iesverhage/crownstone-smart-outlet-tag/documents/Foto's/PCB-3D.jpg

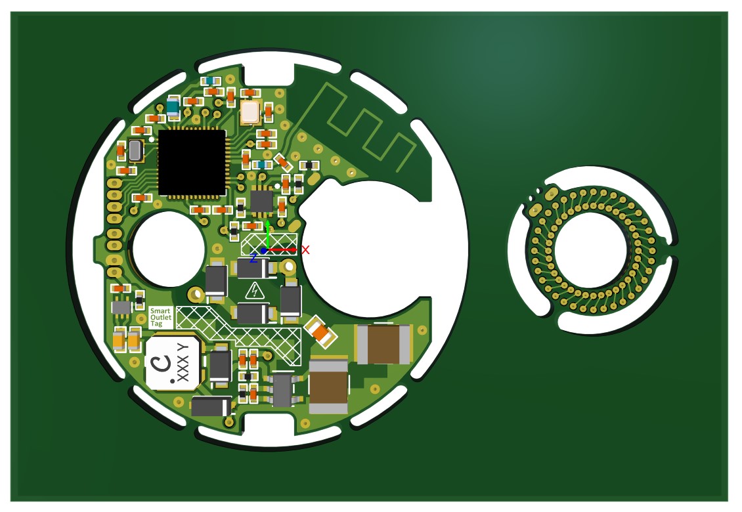
documents/Foto's/PCB-3D.jpg
