iesverhage/crownstone-smart-outlet-tag/documents/Foto's/PCB-2D.jpg

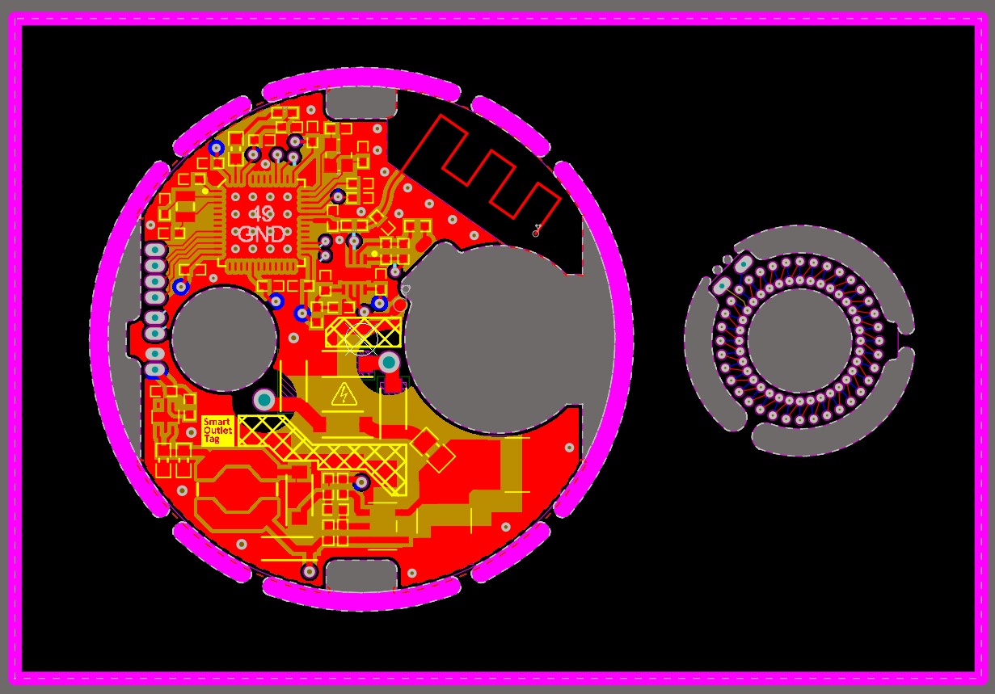
documents/Foto's/PCB-2D.jpg
