iesverhage/crownstone-smart-outlet-tag/documents/Foto's/Circuit.pdf

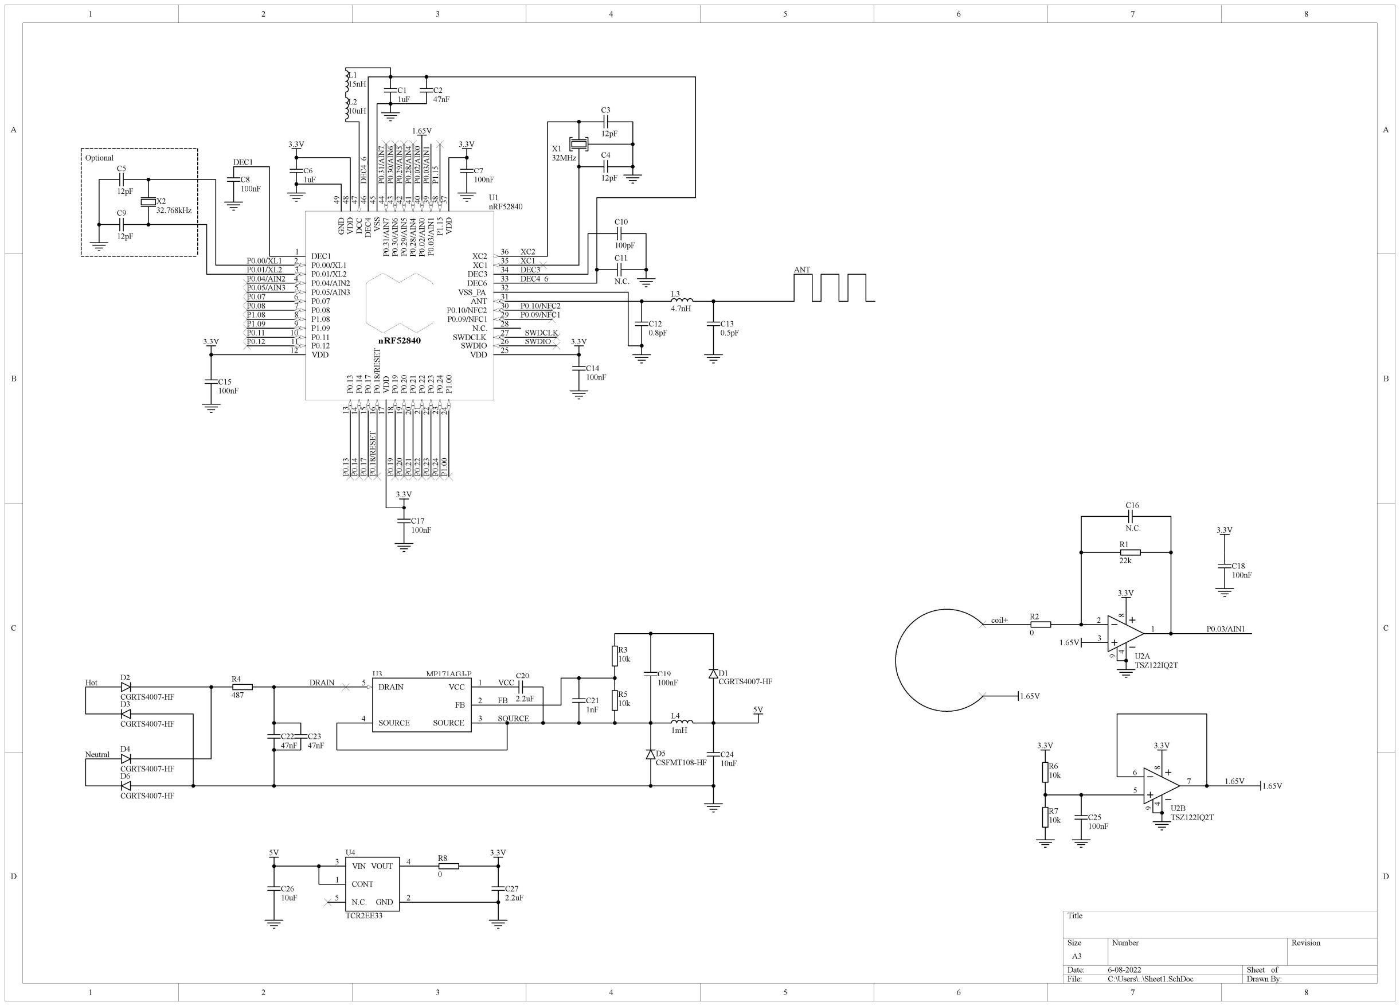
[picture p3: page 1]

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
Title

Size | Number | Revision
A3
Date: | 6-08-2022 | Sheet of
File: | C:\Users\..\Sheet1.SchDoc | Drawn By:

P0.07

P0.11
P0.12

P1.09

P0.00/XL1
P0.01/XL2
P0.04/AIN2
P0.05/AIN3

XC1

XC2

P0.10/NFC2 P⁰.18/RESET | P⁰.19 P⁰.20 P⁰.21 P⁰.22 P⁰.23 | P¹.00

SWDCLK

SWDIO P⁰.02/AIN⁰ P⁰.03/AIN¹

DEC3

P0.09/NFC1

Optional | P¹.15

P0.08

P1.08 | P⁰.13 P⁰.14 P⁰.17 | P⁰.24 P⁰.31/AIN⁷ P⁰.30/AIN⁶ P⁰.29/AIN⁵ P⁰.28/AIN⁴
DEC4_6 DEC⁴_6DEC1

C15
100nF

C17
100nF

C14
100nF

C8
100nF

C7
100nF

C6
1uF

C1
1uF

C9

12pF

C5

12pF

C4

12pF

C3

12pF

C10

100pF

C2
47nF

C11

N.C.

C12
0.8pF

L3
4.7nH

C13
0.5pF

L1
15nH

L2
10uH

X1
32MHz

X2
32.768kHz

DEC1 1

P1.09 9

VSS_PA | 32
ANT | 31
DEC6 | 33 DEC3 | 34 XC1 | 35 XC2 | 36
P0.00/XL1 2
P0.01/XL2 3
P0.04/AIN2 4
P0.05/AIN3 5
P0.07 6
P0.08 7
P1.08 8

P0.11 10
P0.12 11
VDD 12 | P⁰.13 13
SWDIO | 26 SWDCLK | 27 N.C. | 28 P0.09/NFC1 | 29
nRF52840 P⁰.14 14 P⁰.17 15 P⁰.18/RESET 16 VDD 17 P⁰.19 18 P⁰.20 19 P⁰.21 20 P⁰.22 21 P⁰.23 22 P⁰.24 23 P¹.00 24 P⁰.30/AIN⁶ ⁴³ P⁰.31/AIN⁷ ⁴⁴ DEC⁴ ⁴⁶ VSS ⁴⁵ VDD ⁴⁸ DCC ⁴⁷ | P¹.15 38 P⁰.03/AIN¹ ³⁹ P⁰.02/AIN⁰ ⁴⁰ P⁰.28/AIN⁴ ⁴¹ P⁰.29/AIN⁵ ⁴²
VDD | 25
P0.10/NFC2 | 30 GND ⁴⁹ | VDD ³⁷ | U1
nRF52840

ANT

3.3V

coil+

1.65V

1.65V

3.3V

VCC | 1
FB | 2
SOURCE | 3 SOURCE 4

DRAIN 5

U3 | MP171AGJ-P

1

2

3 4

9

8

U2A
TSZ122IQ2T

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
N.C.

C18
100nF

C25
100nF

C19
100nF

D1
CGRTS4007-HF D2

CGRTS4007-HF

D6

CGRTS4007-HF

D5
CSFMT108-HF

C24
10uF

C20

2.2uF

C26
10uF

C27
2.2uF
5V | 3.3V

7

6

5 4

9

8

U2B
TSZ122IQ2T

3.3V

3.3V

C23
47nF

C22
47nF

D3

CGRTS4007-HF

D4

CGRTS4007-HF

L4
1mH

1.65V

R1

22k

Hot

Neutral

FB

VCC

SOURCE

DRAIN

C21
1nF

1.65V

3.3V

3.3V | 3.3V
3.3V | 3.3V

P0.03/AIN1

1.65V

R8

0

R2

0

R4

487

CONT 1

VIN 3

N.C. 5

VOUT | 4
GND | 2

U4

TCR2EE33
