iesverhage/crownstone-smart-outlet-tag/documents/Planning/Planning_v0.9.pdf

Powered by TCPDF (www.tcpdf.org)

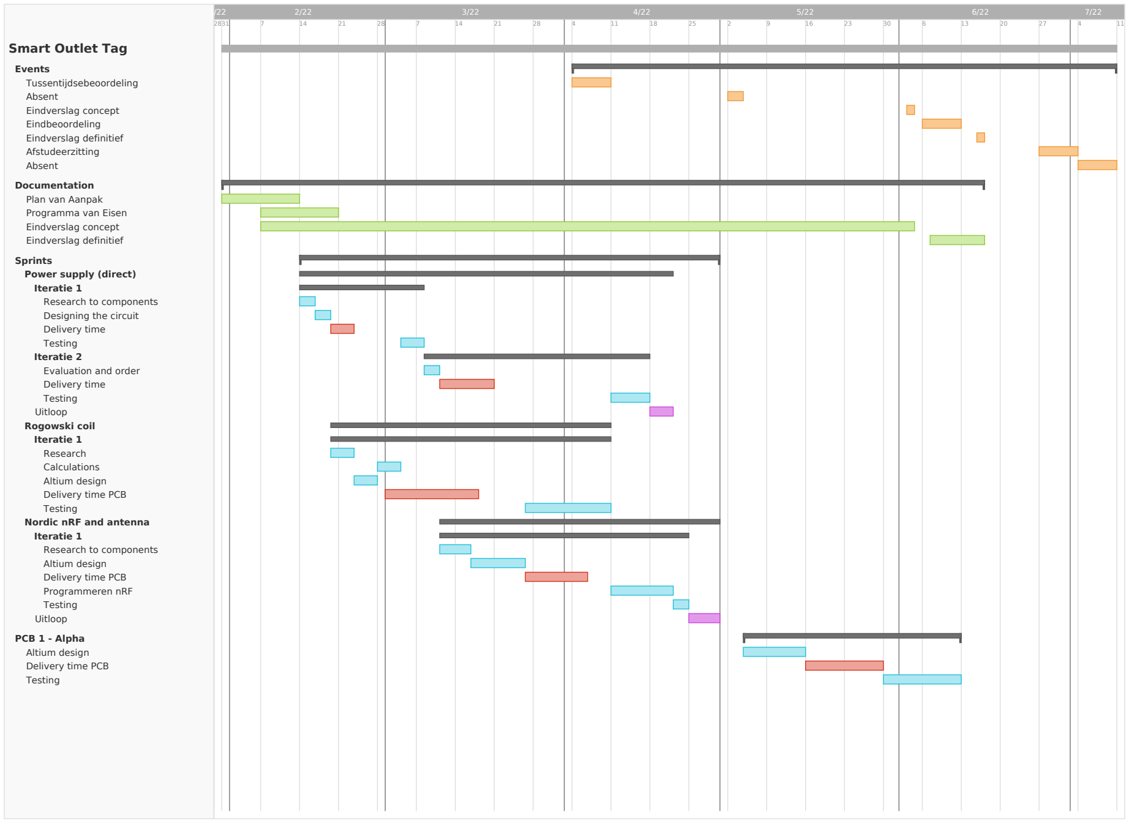
[picture p4: figure]
Smart Outlet Tag; Events Tussentijdsebeoordeling Absent Eindverslag concept Eindbeoordeling Eindverslag definitief Afstudeerzitting Absent; Documentation Plan van Aanpak Programma van Eisen Eindverslag concept Eindverslag definitief; Sprints Power supply (direct) Iteratie 1 Research to components Designing the circuit Delivery time Testing Iteratie 2 Evaluation and order Delivery time Testing Uitloop Rogowski coil Iteratie 1 Research Calculations Altium design Delivery time PCB Testing Nordic nRF and antenna Iteratie 1 Research to components Altium design Delivery time PCB Programmeren nRF Testing Uitloop; PCB 1 - Alpha Altium design Delivery time PCB Testing
