iesverhage/crownstone-smart-outlet-tag/documents/Planning/Planning_v0.7.pdf

4 | 11
| 1/22 | 2/22 3/22 4/22 5/22 6/22 7/22
2831 | | | 7 | 14 | 21 | 28 | 7 | 14 | 21 | 28 | 4 | 11 | 18 | 25 | 2 | 9 | 16 | 23 | 30 | 6 | 13 | 20 | 27
Smart Outlet Tag | 0%
Events | 0%
Tussentijdsebeoordeling | 0%
Absent | 0%
Eindverslag concept | 0%
Eindbeoordeling | 0%
Eindverslag definitief | 0%
Afstudeerzitting | 0%
Absent | 0%
Documentation | 0%
Plan van Aanpak | 0%
Programma van Eisen | 0%
Eindverslag concept | 0%
Eindverslag definitief | 0%
Sprints | 0%
Power supply (direct) | 0%
Iteratie 1 | 0%
Research to components | 0%
Designing the circuit | 0%
Delivery time | 0%
Testing | 0%
Iteratie 2 | 0%
Evaluation and order | 0%
Delivery time | 0%
Testing | 0%
Uitloop | 0%
Rogowski coil | 0%
Iteratie 1 | 0%
Research | 0%
Calculations | 0%
Altium design | 0%
Delivery time PCB | 0%
Testing | 0%
Uitloop | 0%
Nordic nRF and antenna | 0%
Iteratie 1 | 0%
Research to components | 0%
Altium design | 0%
Delivery time PCB | 0%
Programmeren nRF | 0%
Testing | 0%
Uitloop | 0%
PCB 1 - Alpha | 0%
Altium design | 0%
Delivery time PCB | 0%
Testing | 0%

Powered by TCPDF (www.tcpdf.org)
