iesverhage/crownstone-smart-outlet-tag/documents/Planning/Planning_v0.2.pdf

4 | 11
| 1/22 | 2/22 3/22 4/22 5/22 6/22 7/22
2831 | | 7 | 14 | 21 | 28 | 7 | 14 | 21 | 28 | 4 | 11 | 18 | 25 | 2 | 9 | 16 | 23 | 30 | 6 | 13 | 20 | 27
Smart Outlet Tag | 3%
Events | 0%
Tussentijdsebeoordeling | 0%
Absent | 0%
Eindverslag concept | 0%
Eindbeoordeling | 0%
Eindverslag definitief | 0%
Afstudeerzitting | 0%
Absent | 0%
Documentation | 9%
Plan van Aanpak | 80%
Programma van Eisen | 20%
Eindverslag concept | 0%
Eindverslag definitief | 0%
Research | 3%
Energiezuinige voeding | 20%
Kwaliteitseisen / keurmerken | 0%
Antenne | 0%
Stroom meten | 0%
Bevestigings mechanisme | 0%
Design | 0%
Prototype behuizing | 0%
Voeding | 0%
Nordic chip | 0%
Antenne | 0%
Stroom meten | 0%
Simuleren of breadboard schakeling | 0%
PCB 1 - Alpha | 0%
Altium design | 0%
Bestellen PCB / onderdelen | 0%
Testsoftware | 0%
Testen PCB | 0%
PCB 2 - Beta | 0%
Overwegen uitbreidingen | 0%
Altium design | 0%
Bestellen PCB / onderdelen | 0%
Testen PCB | 0%
PCB 3 - Flex PCB | 0%
Altium design | 0%
Bestellen PCB / onderdelen | 0%
Testen PCB | 0%

Powered by TCPDF (www.tcpdf.org)
