iesverhage/crownstone-smart-outlet-tag/documents/Excel sheets/Order list.xlsx

2022-02-21
No. | Choice | Part | Manufacturer | Description | Datasheet | Quantity | Digi-Key | Mouser | Farnell | RoHS | Additional info
1 | 1 | MP100LGN-Z | Monolithic Power Systems | Offline converter |  | 5 | 1589-1521-1-ND | x | 3358118 |  | If not available; order 946-MP103GN-P with FJP5027RTU.
 | 2.1 | 946-MP103GN-P |  | Offline converter |  | 5 | x | 946-MP103GN-P | x |  | Order only with the FJP5027RTU.
 | 2.2 | FJP5027RTU |  | Transistor |  | 10 | x | 512-FJP5027RTU | x |  | Order only with the 946-MP103GN-P.
2 |  | LNK302DN-TL |  | Offline converter |  | 5 | 596-1128-1-ND | 869-LNK302DN-TL | 3364671
3 |  | MP158GJ-P | Monolithic Power Systems | Offline converter |  | 5 | x | 946-MP158GJ-P | x |  | Not necessary but nice to have.
4 |  | 1N4007-T |  | Diode |  | 40 | 1N4007DICT-ND | 583-1N4007-B | 1843698
5 |  | RLB0608-102KL |  | Inductor 1mH |  | 20 | RLB0608-102KL-ND | 652-RLB0608-102KL | x
6 |  | FG20X7S1H106KRT06 |  | Capacitor 10uF/50V |  | 5 | 445-173302-1-ND | 810-FG20X7S1H106KRT6 | 3416646
7 |  | FG28X5R1E106MRT06 |  | Capacitor 10uF/25V |  | 10 | 445-181284-1-ND | 810-FG28X5R1E106MR06 | 3619243
8 |  | FA16X8R1H105KRU06 |  | Capacitor 1uF/50V |  | 10 | 445-175194-1-ND | 810-FA16X8R1H105KRU6 | 3416594
9 |  | RDER72J104K4M1H03A | Murata Electronics | Capacitor 0.1uF/630V |  | 10 | 490-9258-1-ND | 81-RDER72J104K4M1H3A | 2990825
2022-03-15
No. | Choice | Part | Manufacturer | Description | Datasheet | Quantity | Digi-Key | Mouser | Farnell | RoHS | Additional info
1 | 1 | MP171A | Monolithic Power Systems | Offline converter | https://www.monolithicpower.com/en/documentview/productdocument/index/version/2/document_type/Datasheet/lang/en/sku/MP171A/document_id/6918/ | 5 | 1589-MP171AGS-PCT-ND | 946-MP171AGS-P | 3586485 | Compliant
 | 2 | MP172A | Monolithic Power Systems | Offline converter |  | 5 | x | 946-MP172AGJ-P | 3577622 |  | A little bit expensive
 | 3 | MP173A | Monolithic Power Systems | Offline converter |  | 5 | x | 946-MP173AGJ-P | 3442946 |  | A little bit expensive
2 |  | RAA2230114GSP#MA0 | Renesas | Offline converter | https://www.renesas.com/us/en/document/dst/raa223011-datasheet?r=1468636 | 5 | 20-RAA2230114GSP#MA0CT-ND | 968-RAA2230114GSPMA0 | 3773125 | Compliant
3 |  | RDER72J104K4M1H03A | Murata Electronics | Capacitor 0.1uF/630V/X7R | https://nl.mouser.com/datasheet/2/281/RDE_X7R_250V_1kV_E-1670765.pdf | 5 | 490-9258-1-ND | 81-RDER72J104K4M1H3A | 2990825 | Compliant
4 |  | RDER72J103K2M1H03A | Murata Electronics | Capacitor 10nF/630V/X7R | https://nl.mouser.com/datasheet/2/281/RDE_X7R_250V_1kV_E-1670765.pdf | 5 | 490-9257-1-ND | 81-RDER72J103K2M1H3A | 2990823 | Compliant
2022-03-18
No. | Choice | Part | Manufacturer | Description | Datasheet | Quantity | Digi-Key | Mouser | Farnell | RoHS | Additional info | Requirements
1 |  | GJM1555C1HR50RB12D | Murata Electronics | 0.5pF, NP0, ±0.03pF, 50V | https://eu.mouser.com/datasheet/2/281/GJM1555C1HR50RB12_01-1973570.pdf | 1 | x | 81-GJM1555C1HR50RB2D | x | Compliant |  | 0.5pF, NP0, ±5%, 50V
2 |  | GJM1555C1HR80WB01D | Murata Electronics | 0.8pF, NP0, ±0.05pF, 50V | https://eu.mouser.com/datasheet/2/281/GJM1555C1HR80WB01_01-1973626.pdf | 1 |  | 81-GJM1555C1HR80WB1D |  | Compliant |  | 0.8pF, NP0, ±5%, 50V
3 |  | GJM1555C1H1R2WB01D | Murata Electronics | 1.2pF, NP0, ±0.05pF, 50V | https://eu.mouser.com/datasheet/2/281/GJM1555C1H1R2WB01_01-1972990.pdf | 1 |  | 81-GJM1555C1H1R2WB1D |  | Compliant |  | 1.2pF, NP0, ±5%, 50V
4 |  | GJM1555C1H120FB01D | Murata Electronics | 12pF, NP0, ±1%, 50V | https://eu.mouser.com/datasheet/2/281/GJM1555C1H120FB01_01-1972981.pdf | 4 |  | 81-GJM1555C1H120FB1D |  | Compliant |  | 12pF, NP0, ±2%, 25V
5 |  | GRM1555C1H101GA01D | Murata Electronics | 100pF, NP0, ±2%, 50V | https://eu.mouser.com/datasheet/2/281/1/GRM1555C1H101GA01_01A-1982581.pdf | 1 |  | 81-GRM1555C1H101GA1D |  | Compliant |  | 100pF, NP0, ±5%, 25V
6 |  | GRM155R71E473KA88D | Murata Electronics | 47nF, X7R, ±10%, 25V | https://eu.mouser.com/datasheet/2/281/1/GRM155R71E473KA88_01A-1984412.pdf | 1 |  | 81-GRM155R71E473KA88 |  | Compliant |  | 47nF, X7R, ±10%, 10V
7 |  | GRM155R71E104KE14D | Murata Electronics | 100nF, X7R, ±10%, 25V | https://eu.mouser.com/datasheet/2/281/1/GRM155R71E104KE14_01A-1984358.pdf | 5 |  | 81-GRM155R71E104KE4D |  | Compliant |  | 100nF, X7R, ±10%, 16V
8 |  | GRM155R61E105KA12D | Murata Electronics | 1uF, X5R, ±10%, 25V | https://eu.mouser.com/datasheet/2/281/1/GRM155R61E105KA12_01A-1983831.pdf | 2 |  | 81-GRM155R61E105KA2D |  | Compliant |  | 1uF, X7R, ±10%, 16V
9 |  | SC20S-9PF20PPM | Seiko Semiconductors | 32.768kHz, 9pF, ±20PPM | https://eu.mouser.com/datasheet/2/360/SC-20S_Leaflet_e20151217-1530119.pdf | 1 |  | 628-SC20S-9PF20PPM |  | Compliant
10 |  | XRCGB32M000F1H01R0 | Murata Electronics | 32MHz, 8pF, ±10PPM | https://eu.mouser.com/datasheet/2/281/p79e-806516.pdf | 1 |  | 81-XRCGB32M000F1H01R |  | Compliant
11 |  | LQP03TN4N7H02D | Murata Electronics | 4.7nH, 350mA, 400mΩ, ±3% | https://eu.mouser.com/datasheet/2/281/1/JELF243C_0015-1623907.pdf | 1 |  | 81-LQP03TN4N7H02D |  | Compliant
12 |  | 7447840115G | Wurth Elektronik | 15nH, 300mA, 460mΩ, ±2% | https://eu.mouser.com/datasheet/2/445/7447840115G-2492487.pdf | 1 |  | 710-7447840115G |  | Compliant
13 |  | LBMF1608T100K | Taiyo Yuden | 10uH, 80mA, 468mΩ, ±10% | https://eu.mouser.com/datasheet/2/396/wound01_e-1509533.pdf | 1 |  | 963-LBMF1608T100K |  | Compliant
14 |  | AC0402FR-070RL | Yageo | 0Ω, ±1%, 62.5mW | https://eu.mouser.com/datasheet/2/447/Yageo_PYu_AC_51_RoHS_L_7_1714230-1874691.pdf | 1 |  | 603-AC0402FR-070RL |  | Compliant
2022-05-18
No. | Choice | Part | Manufacturer | Description | Datasheet | Quantity | Digi-Key | Mouser | Farnell | RoHS | Additional info
1 |  | CC0402KRX5R8BB225 | Yageo | Capacitor, 2.2uF, X5R, ±10%, 25V |  | 2 |  | 603-CC0402KRX5R8B225 |  | Compliant
2 |  | GRM155R61E102KA01D | Murata | Capacitor, 1nF, X5R, ±10%, 25V |  | 1 |  | 81-GRM155R61E102KA1D |  | Compliant
3 |  | C1812V473KDRACTU | KEMET | Capacitor, 47nF, X7R, ±10%, 1kV, 1812 |  | 2 |  | 80-C1812V473KDR |  | Compliant
4 |  | GRM188R61E106KA73D | Murata | Capacitor, 10uF, X5R, ±10%, 25V, 0603 |  | 2 |  | 81-GRM188R61E106KA3D |  | Compliant
5 |  | CGRTS4007-HF | Comchip Technology | General Purpose Rectifier |  | 5 |  | 750-CGRTS4007-HF |  | Compliant
6 |  | CSFMT108-HF | Comchip | Super Fast Recovery Rectifier |  | 1 |  | 750-CSFMT108-HF |  | Compliant
7 |  | LPZ5010-105MRC | Coilcraft | Inductor, 1mH, 110mA, 28 Ohm |  | 1 |  | x | 2476221 | Compliant
8 |  | RT0402BRD0722KL | Yageo | Resistor, 22k Ohm, ±0.1% |  | 1 |  | 603-RT0402BRD0722KL |  | Compliant
9 |  | AC0402FR-070RL | Yageo | Resistor, 0 Ohm |  | 2 |  | 603-AC0402FR-070RL |  | Compliant
10 |  | RT0402DRE0710KL | Yageo | Resistor, 10k Ohm, ±0.5% |  | 4 |  | 603-RT0402DRE0710KL |  | Compliant
11 |  | RT0805FRE07487RL | Yageo | Resistor, 487 Ohm, ±0.5% |  | 1 |  | 603-RT0805FRE07487RL |  | Compliant
12 |  | BRL2012T101M | Taiyo Yuden | Vaste smoorspoelen 0805 100uH 10.01Ohms +/-20% 85mA |  | 1 |  | 963-BRL2012T101M |  | Compliant
13 |  | TSZ122IQ2T | STMicroelectronics | Operational Amplifier |  | 1 |  | 511-TSZ122IQ2T |  | Compliant
14 |  | MP173AGJ-P | Monolithic Power Systems | Offline regulator |  | 1 |  | 946-MP173AGJ-P |  | Compliant
15 |  | TCR2EE33,LM(CT | Toshiba | LDO 3.3V |  | 1 |  | 757-TCR2EE33LM(CT |  | Compliant
