iesverhage/crownstone-smart-outlet-tag/documents/LTspice/Rogowski coil.asc

C1: cap; 15µF
C9: cap; 45µF
I1: current; SINE(0 14.1 50)
I6: current; SINE(0 1.41 50)
L3: ind2; 119pH
L4: ind2; 122nH
L7: ind2; 86pH
L8: ind2; 112nH
R1: res; 0.6
R7: res; 20k
R12: res; 0.4
R14: res; 1k
U1: LT1797
U2: OP777
V1: voltage; 10
V2: voltage; -10
Named nets: 0, +10V, -10V
.tran 0.1
K1 L3 L4 1
K3 L7 L8 1
.lib opamp.sub
