iesverhage/crownstone-smart-outlet-tag/(commit log)

2022-06-16 Create Smart Outlet Tag - Prototype (11-5-2022 10-16-40).zip
2022-06-16 Create Smart Outlet Tag - Prototype (16-6-2022 09-49-23).zip
2022-06-30 Extra bestanden
    Bestanden die mogelijk nog van pas kunnen komen.
    [LNK302-calculations.xlsx, MP171A-calculations.xlsx, Order list.xlsx, RAA223011-calculations.xlsx]
